tanvikad/balance-robot/docs/index.md

---
layout: page
title: Self Balancing Robot
permalink: /
exclude: true
---

<iframe width="560" height="315" src="https://www.youtube.com/embed/tRsg7kjJD0k" title="YouTube video player" frameborder="0" allow="accelerometer; autoplay; clipboard-write; encrypted-media; gyroscope; picture-in-picture" allowfullscreen></iframe>

<div>
<form action="report" style="display: inline;">
    <input type="submit" style="text-align:center; font-size:1.5em; color:white; background-color:black;display: inline" value="Read our project report" />
</form><form action="https://github.com/echen4628/balance-robot-code" style="display: inline;">
    <input type="submit" style="text-align:center; font-size:1.5em ; color:white; background-color:black;display: inline;" value="Check out our Github" />
</form>
</div>

# Abstract

The goal of our final project is to create a self balancing two wheel robot. When pushed off balance, the robot will move forward and back to regain balance, which we define to be the upright position. We will use a PID control to control the angular velocity of the two wheels to achieve this capability. 
# Authors

<div style="text-align: left">
<span>
 <a href="https://www.linkedin.com/in/eric-chen-2b8726208/" target="_blank">
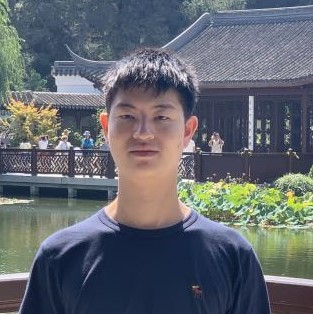
[picture p10: docs/assets/img/Eric_Chen_Image.jpg]
  
 </a>

  <a href="https://www.linkedin.com/in/tanvikadasari" target="_blank">
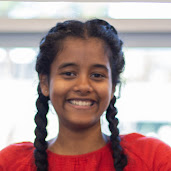
[picture p11: docs/assets/img/Tanvika_Dasari_Image.jpg]
  
 </a>
</span>
</div>
