tanvikad/balance-robot/docs/resources.md

---
layout: page
title: Resources
permalink: /resources/
---

# References

[IMU330DHCX Documentation](https://www.st.com/resource/en/datasheet/ism330dhcx.pdf)

[IMU330DHCX Github](https://github.com/stm32duino/LSM6DSOX/blob/main/src/LSM6DSOXSensor.cpp)

[H-Bridge Documentation](https://www.st.com/content/ccc/resource/technical/document/datasheet/04/ac/22/f9/20/5d/43/a1/CD00000059.pdf/files/CD00000059.pdf/jcr:content/translations/en.CD000000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)

[Robot Kit Instructions](https://learn.adafruit.com/tri-layer-mini-round-robot-chassis-ki)
