tanvikad/balance-robot/docs/assets/schematics/Labeled-MCU-FPGA.png

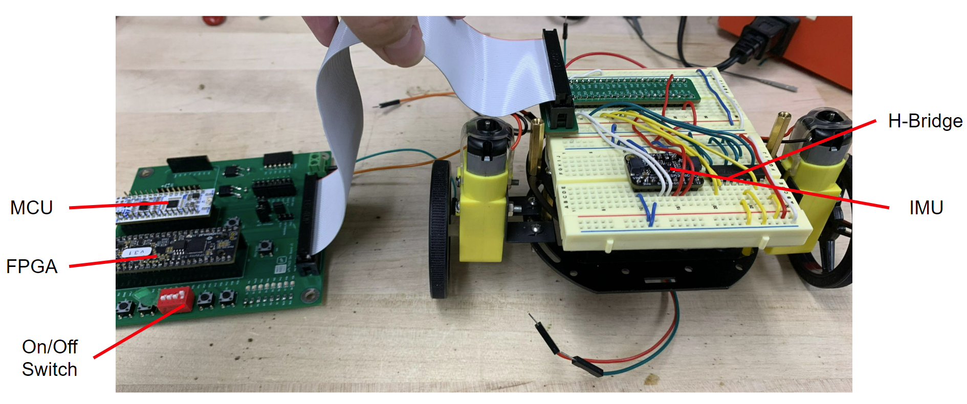
docs/assets/schematics/Labeled-MCU-FPGA.png
