tanvikad/balance-robot/docs/assets/schematics/spi_test_bench.png

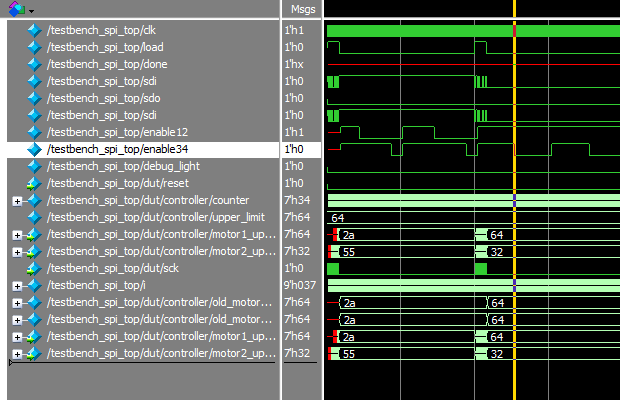
docs/assets/schematics/spi_test_bench.png
