tanvikad/balance-robot/MCU/main.c

/*********************************************************************
*                    SEGGER Microcontroller GmbH                     *
*                        The Embedded Experts                        *
**********************************************************************

-------------------------- END-OF-HEADER -----------------------------

File    : main.c
Purpose : Generic application start

*/

#include <stdio.h>
#include <stdlib.h>
#include "spi.h"
#include "lib/STM32L432KC.h"
#include "lib/PID.h"
#include "lib/helper.h"
