tanvikad/balance-robot/FGPA/source/impl_1/top.sv

/////////////////////////////////////////////
// pwm_spi
// Combines both spi and output and takes in an external clock.
// Added by Tanvika Dasari
// tdasari@hmc.edu
//////////////////////////////////////////////////////////////////////////////////////////
module pwm_spi(
	input logic reset,
	input logic sck,
	input logic clk,
	input logic sdi,
	input logic load,
	output logic sdo,
	output logic enable12,
	output logic enable34,
	output logic a1,
	output logic a2,
	output logic a3,
	output logic a4,
	output logic debug_light
);
	logic [7:0] motor1, motor2;
	spi spi_with_mcu(sck, load, sdi, sdo, motor1, motor2);
	motor_controller controller(reset, load, clk, motor1[7], motor1[6:0], motor2[7], motor2[6:0], enable12, enable34, a1, a2, a3, a4, debug_light);

endmodule


/////////////////////////////////////////////
// top
// The top modules that uses the FPGA oscillator as the clock.
// Added by Tanvika Dasari
// tdasari@hmc.edu
//////////////////////////////////////////////////////////////////////////////////////////
module top(
	input logic reset,
	input logic sck,
	input logic sdi,
	input logic load,
	output logic sdo,
	output logic enable12,
	output logic enable34,
	output logic a1,
	output logic a2,
	output logic a3,
	output logic a4,
	output logic debug_light
);

	// Internal high-speed oscillator
	//(Clock divider selection. 0b00 = 48 MHz, 0b01 = 24 MHz, 0b10 = 12MHz, 0b11 = 6 MHz
	HSOSC #(.CLKHF_DIV(2'b11))
		hf_osc (.CLKHFPU(1'b1), .CLKHFEN(1'b1), .CLKHF(int_osc));
	
	// We are slowing the clock and then feeding into the spi_unit
	logic clk;
	logic[5:0] counter;
	parameter[5:0] limit = 6'd50;
	
	always_ff@(posedge int_osc)
	begin
		if(counter <= limit) counter <= counter+1;
		else 
			begin
				clk <= !clk;
				counter <= 0;
			end
	end
	pwm_spi spi_unit(reset, sck, clk, sdi, load, sdo, enable12, enable34, a1, a2, a3, a4, debug_light);

endmodule
