tanvikad/balance-robot/(commit log)

2022-11-12 added motorcontroller and top
    [FGPA_impl_1_vo.sdf]
2022-11-12 added testbench and modifed motor_controller
    [FGPA_impl_1_vo.sdf]
2022-11-12 added wrapper on top and added device constraint
    [FGPA_impl_1_vo.sdf]
2022-11-12 changed some code on the motor controller
    [FGPA_impl_1_vo.sdf]
2022-11-12 working version of motor running
    [FGPA_impl_1_vo.sdf]
2022-11-12 only fiftypercent duty cycle
    [FGPA_impl_1_vo.sdf]
2022-11-12 starting spi on fpga
2022-11-12 removed fgpa implementation files that are auto generated
    [FGPA_impl_1_vo.sdf]
2022-11-12 changed implmentation for PWM, input is a number from 0 to 100
2022-11-13 fpga spi module
2022-11-13 modified spi and added two byte
2022-11-13 added spi, needed to add load, not simulated
2022-11-13 test values for motor
2022-11-13 adding helper function to control motor values and FPGA reset
    [spi.c]
2022-11-13 got new motor inputs when load is low instead of high and added testbench
2022-11-13 started working on PID and motion model of robot
2022-11-13 added PID code into C
2022-11-16 change mcu spi cpol 1 and cpha 1 and idle cs 1
2022-11-17 fix spi bug
2022-11-17 added header file for SPI and copied functions from proto branch
2022-11-19 added loop with IMU code
2022-11-19 merged imu spi code from imu branch
2022-11-19 added motor into loop
2022-11-19 motor not working
2022-11-21 fix bug where spi does not care about load status
    [spi.sv, top.sv]
2022-11-21 added gyro
2022-11-28 added a timer in MCU
2022-11-28 working timer with spi
2022-11-28 connected PID to the timer
2022-11-29 printed floats
2022-11-29 sigmoid output and send to motors
2022-12-03 somewhat working pid
2022-12-03 semi working pid, can't get off the ground but ok with small angles
2022-12-04 added Prof.Brake's docs into repo
2022-12-09 added more comments to FPGA and timer
2022-12-09 updated the schematics link
2022-12-09 fix buttons
